fotherja/Grid_Tie_Inverter_V5/README.md

# Grid_Tie_Inverter_V5

Please refer to my site ( www.jamesfotherby.com ) where this project is being documented in detail
