fotherja/Grid_Tie_Inverter_V5/GTI_V5_BOM.xlsx

Ref | Qnty | Value | Cmp name | Footprint | Description | Manufacture Part number | Link
C1, C2, C3, C4, C6, C9, C10, C14, C18, C19, C24, C35, C39, C42, C43, C44, C45, C48, C51, C52, C57, C60, C62, C63, C65, C68, C69, C70, | 28 | 100nF | C | Capacitor_SMD:C_0603_1608Metric | Unpolarized capacitor
C5, C21, | 2 | 0.47uF | C | Capacitor_SMD:C_2225_5664Metric | Unpolarized capacitor
C7, C8, C23, C25, C37, C54, C55, | 7 | 2.2uF | C | Capacitor_SMD:C_0603_1608Metric | Unpolarized capacitor
C11, C31, C40, C46, C58, C66, | 6 | 10nF | C | Capacitor_SMD:C_0603_1608Metric | Unpolarized capacitor
C12, C13, C15, C26, C29, C30, | 6 | 22pF | C | Capacitor_SMD:C_0603_1608Metric | Unpolarized capacitor
C16, C17, | 2 | 20pF | C | Capacitor_SMD:C_0603_1608Metric | Unpolarized capacitor
C20, | 1 | 2.2uF | C | Capacitor_THT:C_Rect_L26.5mm_W11.5mm_P22.50mm_MKS4 | Unpolarized capacitor | Film Capacitors 2.2uF 520VDC 10% Rad, 250VAC | https://www.mouser.co.uk/ProductDetail/80-R71VN42204030K
C22, C27, C28, | 3 | 2200pF | C901U222MZVDBA7317 | C901U222MZVDBA7317:C901U222MZVDBA7317 | C900AC SFTY X1-440 Y2-300, Ceramic, 2200 pF, 20%, 440 VAC, 440 VAC (X1), 300 VAC (Y2), 440 VAC, 300 VAC, 2600 VDC, 125C, -40C, Y5V, 5 % , 10 GOhms, 1, 2, 400 mg, 7mm, 5mm, Lead Spacing = 10mm, 18mm, 0.55mm, 1000, 10
C32, | 1 | 470uF | C_Polarized | Capacitor_THT:CP_Radial_D25.0mm_P10.00mm_SnapIn | Polarized capacitor | Aluminium Electrolytic Capacitors - Snap In 450V 470uF 20% 9K Hours | https://www.digikey.co.uk/en/products/detail/united-chemi-con/ESMR451VSN221MQ30S/5824714?so=79236903
C33, | 1 | 2.2uF | C | Capacitor_THT:C_Rect_L18.0mm_W11.0mm_P15.00mm_FKS3_FKP3 | Unpolarized capacitor | Film Capacitors 450V 2.2uF | https://www.mouser.co.uk/ProductDetail/80-R71XI422050H0K
C34, C49, C50, | 3 | 22uF | 595D226X9020B2T | 595D226X9020:CAPPC3328X220N | Solid Tantalum Chip Capacitors TANTAMOUNT(TM), Conformal Coated, Maximum CV |  | https://www.mouser.co.uk/ProductDetail/74-595D226X9020B2T
C36, C53, C61, | 3 | 100pF | C | Capacitor_SMD:C_0603_1608Metric | Unpolarized capacitor
C38, C41, C47, C56, C59, C64, C67, C71, | 8 | 1uF | C | Capacitor_SMD:C_0603_1608Metric | Unpolarized capacitor
C73, | 1 | 10uF | C | Capacitor_SMD:C_0805_2012Metric | Unpolarized capacitor
C74, C75, | 2 | 10uF | C | Capacitor_SMD:C_0603_1608Metric | Unpolarized capacitor
D1, D2, D3, | 3 | SB05W05C-TB-E | SB05W05C-TB-E | SB05W05C:SOT95P250X135-3N | Dual SMT Schottky Diode Common Cathode |  | https://www.mouser.co.uk/ProductDetail/863-SB05W05C-TB-E
D4, | 1 | LED | LED | LED_SMD:LED_0603_1608Metric | Light emitting diode
D5, D7, D10, D11, | 4 | MSS1P4 | B120-E3 | Diode_SMD:D_MicroSMP | 20V 1A Schottky Barrier Rectifier Diode, SMA(DO-214AC) |  | https://www.mouser.co.uk/ProductDetail/Vishay-General-Semiconductor/MSS1P4-M3-89A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
D6, | 1 | DIODE | DIODE | ES1J:DIOM5227X250N | Diode, anode on pin 1, for simulation only!
D8, D9, | 2 | 512-ES1J | MRA4005T3G | Diode_SMD:D_SMA | 600V, 1A, General Purpose Rectifier Diode, SMA(DO-214AC) |  | https://www.mouser.co.uk/ProductDetail/onsemi-Fairchild/ES1J?qs=ZaZfTJZxiphg%252BqNC2EhLqQ%3D%3D
H1, H2, H3, H4, | 4 | MountingHole | MountingHole | MountingHole:MountingHole_3.2mm_M3 | Mounting Hole without connection
H5, | 1 | MountingHole_Pad | MountingHole_Pad | MountingHole:MountingHole_2.2mm_M2_Pad | Mounting Hole with connection
IC3, IC7, IC8, | 3 | MAX253CSA+ | MAX253CSA+ | MAX253CSA:SOIC127P600X175-8N | MAX253CSA+, General Purpose Driver, 8-Pin, SOIC N |  | https://www.mouser.co.uk/ProductDetail/700-MAX253CSA
IC4, IC5, IC6, IC9, | 4 | AMC1306M25QDWVRQ1 | AMC1306M25QDWVRQ1 | AMC1306:SOIC127P1150X280-8N | Data Acquisition ADCs/DACs - Specialized Automotive, +/-250-mV input, precision reinforced isolated modulator with CMOS interface |  | https://www.mouser.co.uk/ProductDetail/595-MC1306M25QDWVRQ1
J1, | 1 | Screw_Terminal_01x03 | Screw_Terminal_01x03 | TerminalBlock:TerminalBlock_bornier-3_P5.08mm | Generic screw terminal, single row, 01x03, script generated (kicad-library-utils/schlib/autogen/connector/)
J2, J3, | 2 | Screw_Terminal_01x02 | Screw_Terminal_01x02 | TerminalBlock:TerminalBlock_bornier-2_P5.08mm | Generic screw terminal, single row, 01x02, script generated (kicad-library-utils/schlib/autogen/connector/)
J4, | 1 | Conn_01x05_Male | Conn_01x05_Male | Connector_PinHeader_1.27mm:PinHeader_1x05_P1.27mm_Vertical | Generic connector, single row, 01x05, script generated (kicad-library-utils/schlib/autogen/connector/)
J5, J6, | 2 | Conn_01x02_Male | Conn_01x02_Male | Connector_PinHeader_1.27mm:PinHeader_1x02_P1.27mm_Vertical | Generic connector, single row, 01x02, script generated (kicad-library-utils/schlib/autogen/connector/)
K1, K2, | 2 | G5LE-1 | G5LE-1 | Relay_THT:Relay_SPDT_Omron-G5LE-1 | Omron G5LE relay, Miniature Single Pole, SPDT, 10A |  | https://www.mouser.co.uk/ProductDetail/653-G5LE-1-VDDC12
L1, L2, | 2 | 2mH | L_Iron | Inductor_THT:L_Toroid_Vertical_L35.1mm_W21.1mm_P18.50mm_Vishay_TJ6 | Inductor with iron core |  | https://powermagneticsstore.co.uk/shop/fs-185090-2.html
L4, | 1 | 1mH | L_Iron | Inductor_THT:L_Toroid_Vertical_L41.9mm_W19.1mm_P15.80mm_Vishay_TJ7 | Inductor with iron core |  | https://powermagneticsstore.co.uk/shop/fs-185090-2.html
L5, | 1 | 744824622 | 744824622 | 744824622:WE-CMB_L5 | Current Compensated Choke WE-CMB | Common Mode Chokes / Filters WE-CMB Choke Type L 2.2mH 6A 20mOhm | https://www.mouser.co.uk/ProductDetail/710-744824622
PS1, PS2, PS3, | 3 | AP2210K-5.0TRG1 | AP2210K-5.0TRG1 | AP2210K-5.0TRG1:SOT95P282X130-5N | LDO Voltage Regulators 300mA CMOS LDO 5.0V 250mV |  | https://www.mouser.co.uk/ProductDetail/621-AP2210K-5.0TRG1
Q1, Q3, Q4, Q5, | 4 | BUZ11 | BUZ11 | Package_TO_SOT_THT:TO-220-3_Vertical | 30A Id, 50V Vds, N-Channel Power MOSFET, TO-220 |  | https://www.st.com/resource/en/datasheet/stp16nf06.pdf
Q2, | 1 | 2N7002 | 2N7002 | Package_TO_SOT_SMD:SOT-23 | 0.115A Id, 60V Vds, N-Channel MOSFET, SOT-23
R1, R34, | 2 | 4.7R | R | Resistor_SMD:R_0603_1608Metric | Resistor
R2, R3, R38, R39, R40, | 5 | 47R | R | Resistor_SMD:R_0603_1608Metric | Resistor
R12, R20, R27, R29, R33, R44, | 6 | 1K | R | Resistor_SMD:R_0603_1608Metric | Resistor
R5, R8, R9, R24, R25, R26, | 6 | 470K | R | Resistor_SMD:R_0805_2012Metric | Resistor
R6, R15, R35, R41, | 4 | 2.2R | R | Resistor_SMD:R_0603_1608Metric | Resistor
R7, | 1 | 6.8R | R | Resistor_SMD:R_2512_6332Metric | Resistor
R10, | 1 | 50mR | R | Resistor_SMD:R_2512_6332Metric | Resistor
R11, R18, R19, R21, R22, R31, R36, R42, | 8 | 10R | R | Resistor_SMD:R_0603_1608Metric | Resistor
R13, R32, R37, R43, | 4 | 10K | R | Resistor_SMD:R_0603_1608Metric | Resistor
R14, | 1 | 20mR | R | Resistor_SMD:R_2512_6332Metric | Resistor
R30, | 1 | 4.7K | R | Resistor_SMD:R_0603_1608Metric | Resistor
T1, | 1 | 750316770 | 750316770 |  | Power Transformers 1W Push Pull TOR4.3/2.8/2.3 | 5 to 12V | https://www.mouser.co.uk/ProductDetail/710-750316770
T2, T3, | 2 | 760390014 | 760390014 | 760390014:760390015 | Audio Transformers / Signal Transformers MID-SN6501 TI Driver Toroid .475mH 5VDC | 5 to 5V | https://www.mouser.co.uk/ProductDetail/710-760390014
U1, | 1 | STM32L475RCTx | STM32L475RCTx | Package_QFP:LQFP-64_10x10mm_P0.5mm | ARM Cortex-M4 MCU, 256KB flash, 128KB RAM, 80MHz, 1.71-3.6V, 51 GPIO, LQFP-64 | STM32L475RCT3 | https://www.mouser.co.uk/ProductDetail/511-STM32L475RCT3
U2, U5, | 2 | UCC21520ADW | UCC21520ADW | Package_SO:SOIC-16W_7.5x10.3mm_P1.27mm | Isolated Dual-Channel Gate Driver, Output Current 4.0/6.0A, 5.7kV Isolation, 5V UVLO, SOIC-16W
U3, | 1 | AZ1117-5.0 | AZ1117-5.0 | AZ1117CD-5.0TRG1:AZ1117CD50TRG1 | 1A 20V Fixed LDO Linear Regulator, 5.0V, SOT-89/SOT-223/TO-220/TO-252/TO-263 |  | https://www.mouser.co.uk/ProductDetail/Diodes-Incorporated/AZ1117CD-5.0TRG1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
U4, | 1 | TC2117-3.3VDBTR | TC2117-3.3VDBTR | Package_TO_SOT_SMD:SOT-223-3_TabPin2 | 1A Low drop-out regulator, Fixed Output 3.3V, SOT-223 |  | https://www.mouser.co.uk/ProductDetail/Microchip-Technology/TC2117-3.3VDBTR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
Y1, | 1 | Crystal_GND24 | Crystal_GND24 | Crystal:Crystal_SMD_Abracon_ABM10-4Pin_2.5x2.0mm | Four pin crystal, GND on pins 2 and 4 | ABM10-16.000MHZ-D30-T3 | https://www.mouser.co.uk/ProductDetail/ABRACON/ABM10-16.000MHZ-D30-T3?qs=yJy3i4hRrMhOYZI5v9%2F5mA%3D%3D
