fotherja/Grid_Tie_Inverter_V5/(threads)

Thread 1 (2023-03-18):

External pulldown for PWM enable

hydroid7, 2023-03-18:
Hi there,

the state of the IOs is only guaranteed to be stable only after reset. Even then, the pull-up/down resistors are only 40k (see [datasheet](https://static6.arrow.com/aropdfconversion/816a3c5cd038f14b9f633d563429525ba36ff4dc/7dm00172872.pdf), p. 127).

I think adding a 10k pulldown to the `PWM_Disable` would help to keep this pin in a stable (off) state.
In case it does not required it can be left unpopulated on the PCB.

Cheers!

fotherja, 2023-03-20:
Totally agree with you. I'll add this. Thanks. The PCBs have been shipped and should be with me in about 1 week.

hydroid7, 2023-03-20:
Sure! Do you plan to keep this repo alive or create a new one?

fotherja, 2023-03-27:
Hopefully keep this one alive from now on

Thread 2 (2023-03-20):

Prevent relay arcing with snubber circuit

hydroid7, 2023-03-20:
In case of a forceful diconnect from the grid, currents can flow through the relais, which can lead to building up an arc.

The EMI caused by the arc can cause the microcontroller get into an undefined state e. g. this [StackExchange question].
Therefore it would be nice to include a protection for prevent arcing.
This could be done with RC snubber circuits or with an additional solid state relay, as mentioned in the question.

[StackExchange question]: https://electronics.stackexchange.com/questions/308379/switching-hv-dc-relay-on-crashes-microcontroller

Flole998, 2023-03-20:
RC snubbers are not a good idea as there's still current flowing. With such small currents this shouldn't be an issue at all, I'm switching much larger loads and motors on other PCBs without ever seeing a MCU crash due to that.

hydroid7, 2023-03-21:
Glad to hear that your design works well.

Indeed, the SMA SB2500 uses also 3 relays for this reason.

Flole998, 2023-03-28:
But that's not necessary at all, you simply don't have to switch those under load. As the inverter has FETs aswell for converting DC to AC you simply switch the (unnecessary) relay only after making sure the FETs are off.

Keep in mind that with additional components that permanently consume electricity while the inverter is operating the efficiency goes down.

fotherja, 2023-03-28:
I agree with you Flole998. I did question the necessity of the relays given how much space they take up. I saw them on some GTI reference designs and figured they improved the safety of the system. They will also allow the current sensors to be zeroed more accurately.

fotherja, 2023-03-30:
hydroid7 - I've only just understood your point!

I have realised that if the relays were to open with 6Amps flowing through them then the grid side inductor (1mH) is going to force some horrid voltages. There is also an output fuse and if that were to blow then we'd also get horrid voltages.

The relays shouldn't switch under load in normal operation but they could... I will add a 400V TVS to the output but that won't fix the potential for arcing when the relays open. I can see an RC snubber fixing this issue well. Don't you agree Flole998?

Flole998, 2023-03-30:
I don't think that actually matters, but even if you add it in case someone doesn't want it they can simply leave it unpopulated.

fotherja, 2023-03-30:
What do you think wouldn't matter? The potential for arcing?

If a relay opened with current flowing would it not create a large (damaging 1000s volts) common mode voltage between the inverter output and the bus voltage?

Flole998, 2023-03-30:
Well if the purpose of the relay is to do galvanic isolation then adding the RC circuit would be against the purpose.

The only reason I can think of why the relay would turn off when current is flowing through it is a DC disconnect under load, which shouldn't normally happen. Even if it does, the FETs should be turning off faster than the relay, so it would not switch under load anyways.

hydroid7, 2023-03-30:
Yes, a TVS would also solve the problem. I think all our statements are partially correct.

The SMA-SB2500 uses 3 relays, one with a resistance and two for disconnect. Their design is also a little bit different, so it's OK not to include it into this design.

For example, to do an over current disconnect, you open the relay with the resistance in parallel.
Then to disconnect fully, you open the isolation relais.

However, since PCB is cheap and as @Flole998 also mentioned, it can be included and marked as DNP.

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

Flole998, 2023-03-30:
You could also add a Varistor, that's cheaper (but if it's frequently used it will break at some point).

Thread 3 (2024-01-15):

Schematic update

folny, 2024-01-15:
Hi James

I'm going to try to build your GTI 5 project, but I'm going to modify the PCB to only 2 layers and I want to add ModBus communication to support the smart meter DTSU666 to prevent the flow to the distribution network. Do you have any ideas what I could change and which unnecessary components I can remove from the scheme ?.

fotherja, 2024-01-15:
Hi, Sounds good, I'd be very interested to hear your progress as you go along, keep in touch.  How are you going to be generating your DC bus voltage?

As to possible changes, it depends on what you're aiming for but simplifications that could be considered:
1) Don't bother measuring capacitor current so get rid of the associated 5v isolated supply and the AMC1306
2) Do you want the relays?

Don't forget the TVS.

folny, 2024-01-16:
Instead of measuring the capacitor current, I would like to measure the DC input current, which would be more useful. Furthermore, I am thinking of removing the damping coil L4, I would definitely leave the relay there for safety reasons. I am also thinking about DC Boost at the input, as some professional inverters have.

block diagram Sofar solar https://www.sofarsolar.com/upload/file/20230920/1695196218979040710.pdf

fotherja, 2024-01-16:
The reason for measuring the capacitor current is because it allows you to do active filtering of the LCL resonance in software. That increases efficiency because it allows you to reduce/eradicate the damping resistance in the LCL filter. It's a technique I haven't done yet but I built the inverter in anticipation of trying it out. Don't think any of that can be done by measuring the DC input current.

folny, 2024-01-16:
Yes, I understand that it is not possible by measuring the input current, I had in mind that if the capacitor current measurement still does not work, then I will use the components to measure the input current and calculate the input and output power to calculate the efficiency of the inverter.

folny, 2024-01-16:
Check out this budding project, it looks like it's going to be a great project too.

https://github.com/OpenCleanEnergy/OpenMI

fotherja, 2024-01-16:
That OpenMI project is fantastic! Thank you very much for bringing it to my attention. I shall follow it closely. Keep me updated with your progress too

folny, 2024-01-17:
I am also very curious about the first working prototype of OpenMI. The PCBs for your project will arrive next week so I will test it and let you know how my modified PCB work. My goal is to make an inverter with a power of at least 2000W.

Thread 6 (2024-02-24):

I made a new board, but cannot compile the project

gigaj0ule, 2024-02-24:
Hello hackers!

I just built an improved board for this inverter, with simpler layout, and fewer components, and just finished assembling it today!

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

However, when I try to compile the stm32 project, I cannot do so in the stm32cubeIDE.

Since there is no .project file in the repository, I attempt to create my own from the .IOC file, but am encountering errors of all kinds.

Do we still have the .project file? Or, a makefile?

folny, 2024-02-24:
Hi

I also modify this project according to myself and I do the programming in Windows in ARM Keil uVision 5.38 and I have no problem with the compilation. If you decide to use this option, write here and I will give a printscreen of how and what needs to be set in KEIL ARM.

folny, 2024-02-24:
Here is the code set up and compiled in KEIL ARM, hex files can be found in STM32CubeIDE_Code\MDK-ARM\GTI_v5

[STM32CubeIDE_Code.zip](https://github.com/fotherja/Grid_Tie_Inverter_V5/files/14392029/STM32CubeIDE_Code.zip)

folny, 2024-02-24:
I use this program for debugging which is better than debugging in Keil

https://github.com/klonyyy/STMViewer

gigaj0ule, 2024-02-24:
thank you :-)

by any chance, are you able to see the terminal output when compiling?

compiler flags should be included in the debug spew, and although the MDK flags aren’t all going to be the same as GCC ones, I may be able to cross reference them and add to the makefile.

i think the debug output of STM32CUBEIDE should be identical to arm-none-eabi, since it uses GCC internally

folny, 2024-02-24:
I also tried to build the project in STM32CubeIDE and the compilation went without any problems.
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
