fotherja/Grid_Tie_Inverter_V5/(commit log)

2023-03-16 Hardware
    The PCB has been designed and sent for manufacturing
    [GTI_V5-B_Cu.gbr, GTI_V5-B_Mask.gbr, GTI_V5-B_Paste.gbr, GTI_V5-B_Silkscreen.gbr, GTI_V5-Edge_Cuts.gbr, GTI_V5-F_Cu.gbr, GTI_V5-F_Mask.gbr, GTI_V5-F_Paste.gbr]
2023-03-29 PCB now assembled - with these component values
    The hardware deadtime resistors on the UCC21520 are 4.7K for a 47ns deadtime. This can always be increased further in software on the STM32L475
    [GTI_V5.kicad_pcb, GTI_V5.kicad_sch]
2023-03-29 updated schematic inductor values that I'm using
    [GTI_V5.kicad_sch]
2023-03-29 Added BOM to repo
    [GTI_V5_BOM.xlsx]
2023-03-29 Added Schematic PDF
2023-03-31 First code upload
    This code performs most of the necessary functions including:
    - Outputting PWM
    - Implementing a PLL
    - Performing safety checks and overcurrent/voltage protection using the analog watchdog on the DFSDM peripheral
    - Implementing a PR (proportional resonant) controller
    Plenty still to do:
    - Add harmonic compensation
    - Control the current output setpoint based on feedback of measured RMS current/power
    - UART to interface with a PC/Microcontroller
    - Calibration routines
    - Grid impedance measurements
2023-03-31 Successful grid tie
    Successfully grid tied and output 40W through a 12V transformer (waiting for a TVS prior to going to higher voltages)
    We have the PR working with a 150Hz compensator - will be easy to add more (250 and 350Hz compensators)
    Next I won't to implement a CPU monitor to see how much processing power we have left (plenty I hope, although HAL is so inefficient)
    [GTI_v5.ioc, main.c, main.h]
2023-06-25 600W Grid Tied
    Working brilliantly. We employ:
    - PI control + Resonant controller + Harmonic compensators
    - Feedforward control
    - With have a PI loop which adjusts our output current to pull the bus voltage to 370 Volts
2023-06-27 Add files via upload
    corrected schematic gate drive resistor symbols (4.7K to 4.7R)
