fotherja/Grid_Tie_Inverter_V5/(notices)

Notices in the files:
STM32CubeIDE_Code/Core/Src/PID.c:
This program is free software: you can redistribute it and/or modify it under
the terms of the GNU General Public License as published by the Free Software
STM32CubeIDE_Code/Core/Inc/main.h:
Copyright (c) 2023 STMicroelectronics.
All rights reserved.
This software is licensed under terms that can be found in the LICENSE file
STM32CubeIDE_Code/Core/Src/main.c:
MIT License
Copyright (c) [2023] [James Fotherby]
